AbdullahJalloul/Thermostat_V1/Kicad/Image/Thermostat_V1 top.png

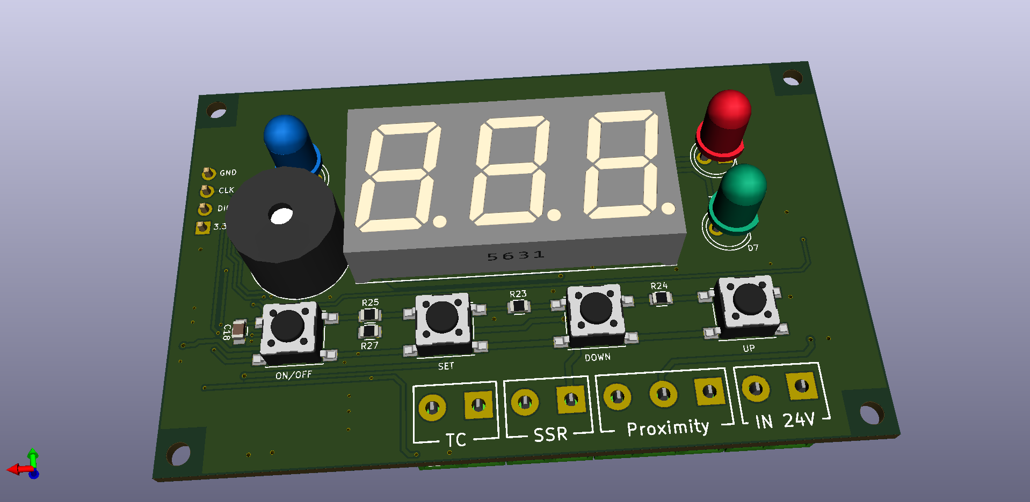
Kicad/Image/Thermostat_V1 top.png
