AbdullahJalloul/Thermostat_V1/Kicad/Image/Thermostat_V1 bot.png

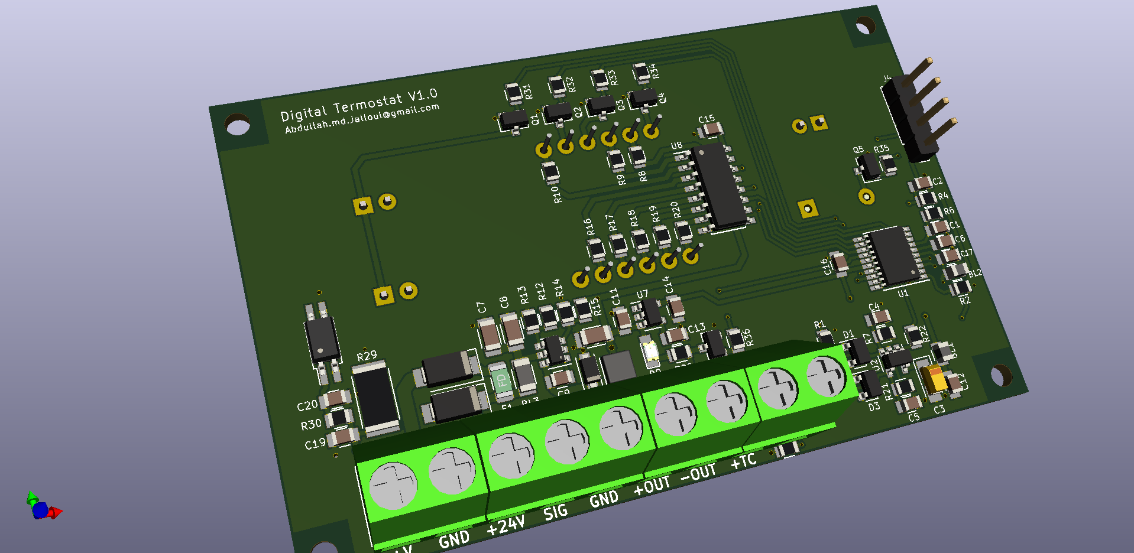
Kicad/Image/Thermostat_V1 bot.png
