AbdullahJalloul/Thermostat_V1/Kicad/Thermostat_V1.sch

## KiCad design Kicad/Thermostat_V1.sch (2019-05-15)

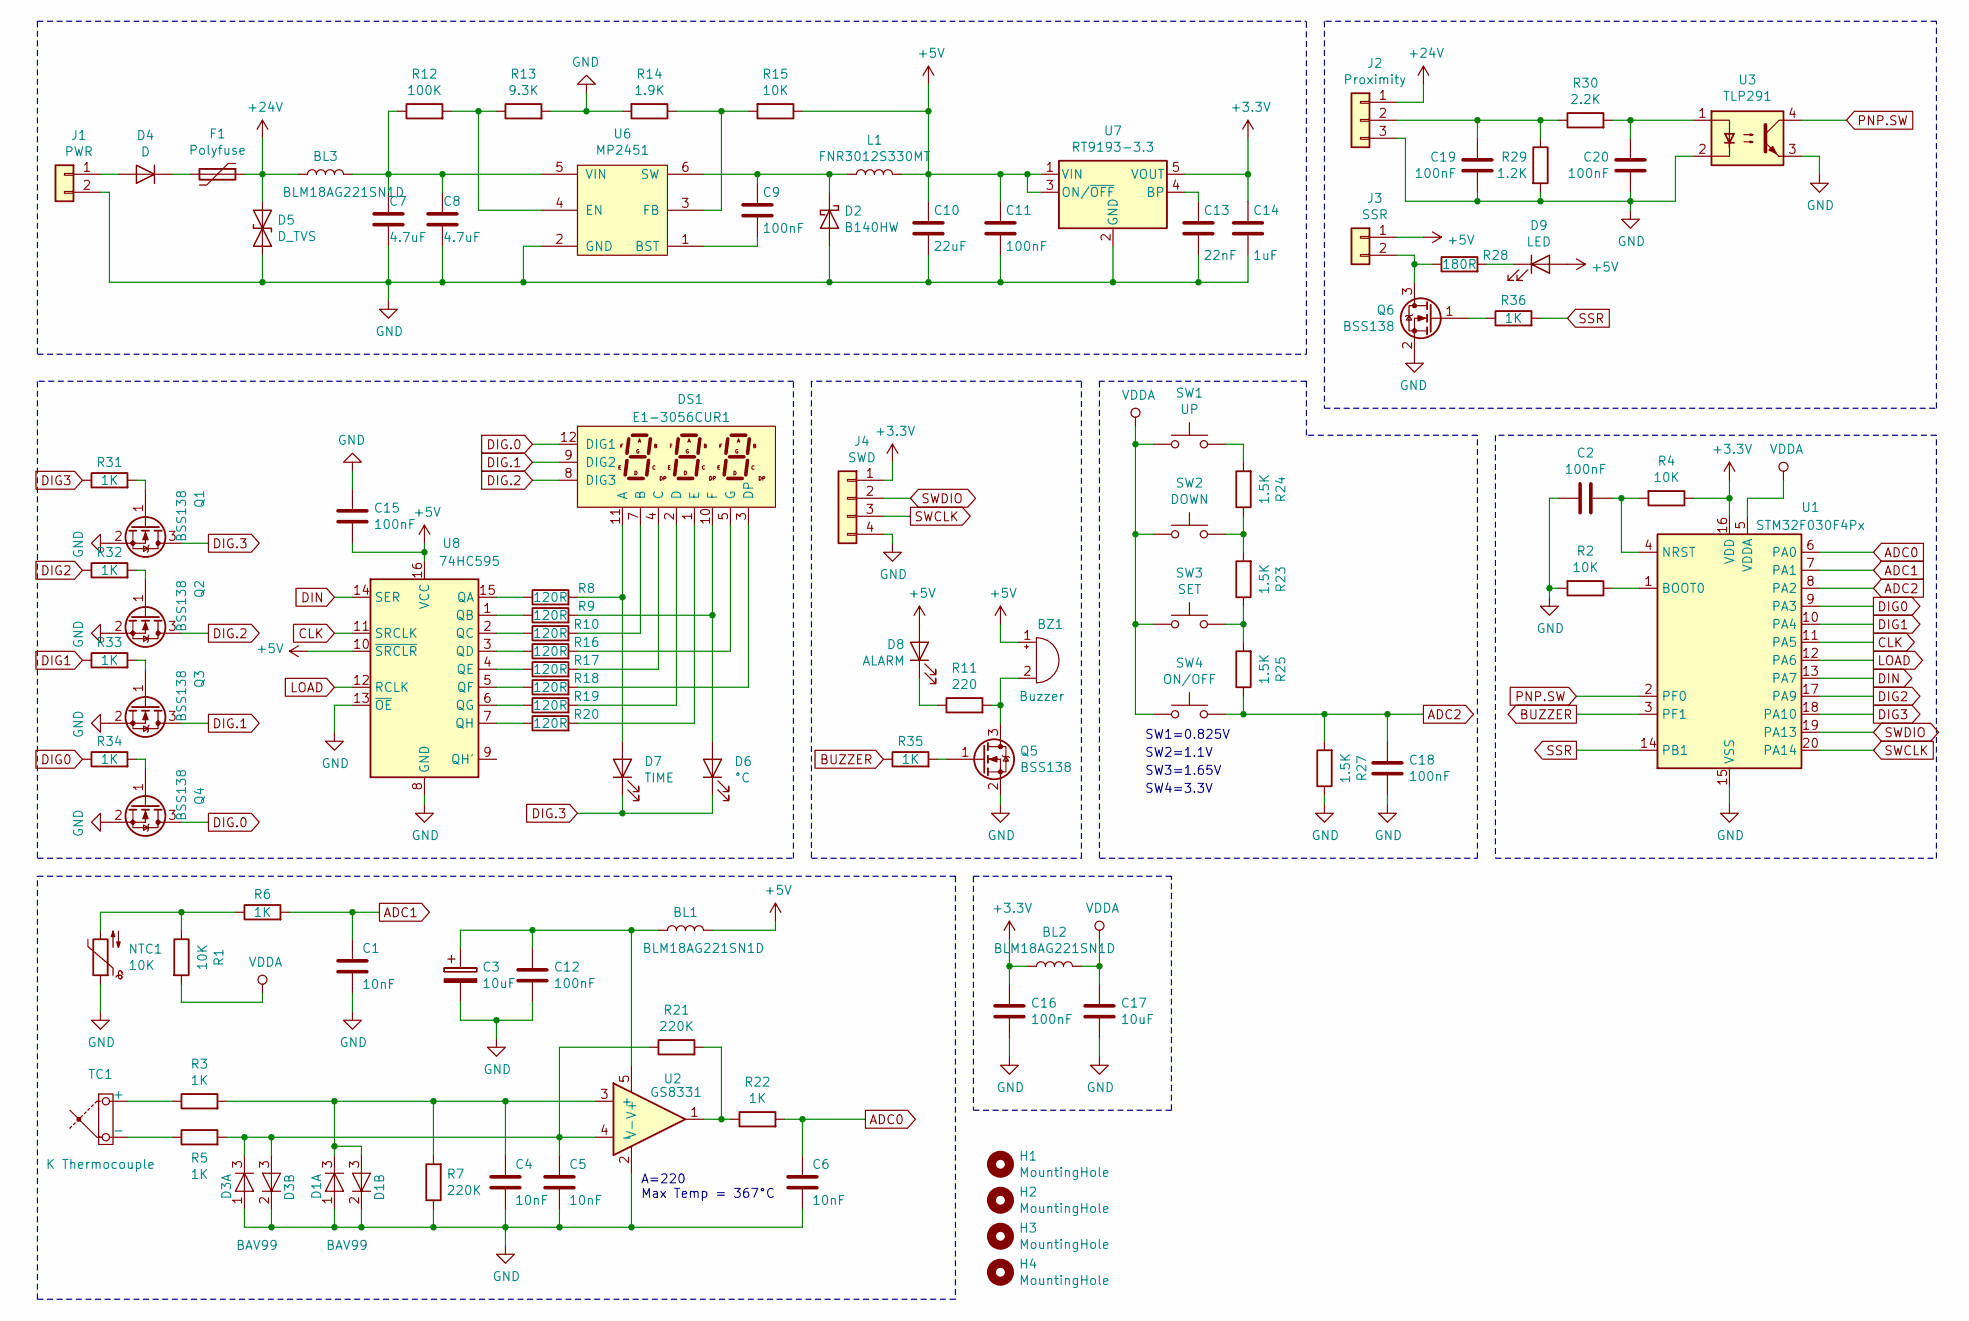
[picture p3: schematic Thermostat_V1.sch]

Parts:
BL1, BL2: BLM18AG221SN1D; L_0805
BL3: BLM18AG221SN1D; L_1206
BZ1: Buzzer; Buzzer_12x9.5RM7.6
C1, C4, C5, C6: 10nF; C_0805
C2, C9, C11, C12, C15, C16, C18, C19, C20: 100nF; C_0805
C3: 10uF; CP_Tantalum_Case-A_EIA-3216-18_Reflow
C7, C8: 4.7uF; C_1206
C10: 22uF; C_1206
C13: 22nF; C_0805
C14: 1uF; C_0805
C17: 10uF; C_0805
D1, D3: BAV99; SOT-23
D2: B140HW; D_SOD-123F
D4: D; D_SMA
D5: D_TVS; D_SMA
D6: °C; LED_D5.0mm
D7: TIME; LED_D5.0mm
D8: ALARM; LED_D5.0mm
D9: LED; LED_0805
DS1: E1-3056CUR1; E1-3056-CUR-1-CT
F1: Polyfuse; Fuse_1206_3216Metric
H1, H2, H3, H4: MountingHole; MountingHole_2.5mm
J1: PWR; TerminalBlock_bornier-2_P5.08mm
J2: Proximity; TerminalBlock_bornier-3_P5.08mm
J3: SSR; TerminalBlock_bornier-2_P5.08mm
J4: SWD; Pin_Header_Straight_1x04_Pitch2.54mm
L1: FNR3012S330MT; L_Taiyo-Yuden_MD-3030
NTC1: 10K; R_0805
Q1, Q2, Q3, Q4, Q5, Q6: BSS138; SOT-23
R1, R2, R4, R15: 10K; R_0805
R3, R5, R6, R22, R31, R32, R33, R34, R35, R36: 1K; R_0805
R7, R21: 220K; R_0805
R8, R9, R10, R16, R17, R18, R19, R20: 120R; R_0805
R11: 220; R_0805
R12: 100K; R_0805
R13: 9.3K; R_0805
R14: 1.9K; R_0805
R23, R24, R25, R27: 1.5K; R_0805
R28: 180R; R_0805
R29: 1.2K; R_2512
R30: 2.2K; R_0805
SW1: UP; SW_SPST_PTS645
SW2: DOWN; SW_SPST_PTS645
SW3: SET; SW_SPST_PTS645
SW4: ON/OFF; SW_SPST_PTS645
TC1: K Thermocouple; TerminalBlock_bornier-2_P5.08mm
U1: STM32F030F4Px; TSSOP-20_4.4x6.5mm_Pitch0.65mm
U2: GS8331; SOT-23-5
U3: TLP291; SO-4_4.4x2.3mm_Pitch1.27mm
U6: MP2451; SOT-23-6
U7: RT9193-3.3; SOT-23-5
U8: 74HC595; SOIC-16_3.9x9.9mm_Pitch1.27mm

Connections:
+3.3V: BL2.1, C14.2, C16.2, J4.1, R4.1, U1.16 (VDD), U7.5 (VOUT)
+5V: BL1.2, BZ1.1 (-), C10.2, C11.2, C15.1, D8.2 (A), D9.2 (A), J3.1, L1.2, R15.1, U7.1 (VIN), U7.3 (ON/~OFF~), U8.10 (~SRCLR), U8.16 (VCC)
+24V: BL3.1, D5.1 (A1), F1.1, J2.1
ADC0: C6.2, R22.2, U1.6 (PA0)
ADC1: C1.2, R6.2, U1.7 (PA1)
ADC2: C18.2, R25.1, R27.2, SW4.2, U1.8 (PA2)
BUZZER: R35.1, U1.3 (PF1)
CLK: U1.11 (PA5), U8.11 (SRCLK)
DIG0: R34.1, U1.9 (PA3)
DIG1: R33.1, U1.10 (PA4)
DIG2: R32.1, U1.17 (PA9)
DIG3: R31.1, U1.18 (PA10)
DIG.0: DS1.12 (DIG1), Q4.3 (D)
DIG.1: DS1.9 (DIG2), Q3.3 (D)
DIG.2: DS1.8 (DIG3), Q2.3 (D)
DIG.3: D6.1 (K), D7.1 (K), Q1.3 (D)
DIN: U1.13 (PA7), U8.14 (SER)
GND: C1.1, C2.1, C3.2, C4.1, C5.1, C6.1, C7.1, C8.1, C10.1, C11.1, C12.1, C13.1, C14.1, C15.2, C16.1, C17.1, C18.1, C19.1, C20.1, D1.1 (A), D1.2 (K), D2.2 (A), D3.1 (A), D3.2 (K), D5.2 (A2), J1.2, J2.3, J4.4, NTC1.1, Q1.2 (S), Q2.2 (S), Q3.2 (S), Q4.2 (S), Q5.2 (S), Q6.2 (S), R2.2, R7.1, R13.2, R14.2, R27.1, R29.2, U1.15 (VSS), U2.2 (V-), U3.2, U3.3, U6.2 (GND), U7.2 (GND), U8.8 (GND), U8.13 (~OE)
LOAD: U1.12 (PA6), U8.12 (RCLK)
unnamed: BL1.1, C3.1, C12.2, U2.5 (V+)
unnamed: BL3.2, C7.2, C8.2, R12.1, U6.5 (VIN)
unnamed: BZ1.2 (+), Q5.3 (D), R11.2
unnamed: C2.2, R4.2, U1.4 (NRST)
unnamed: C4.2, D1.3 (K), R3.2, R7.2, U2.3 (+)
unnamed: C5.2, D3.3 (K), R5.2, R21.1, U2.4 (-)
unnamed: C9.1, U6.1 (BST)
unnamed: C9.2, D2.1 (K), L1.1, U6.6 (SW)
unnamed: C13.2, U7.4 (BP)
unnamed: C19.2, J2.2, R29.1, R30.1
unnamed: C20.2, R30.2, U3.1
unnamed: D4.1 (K), F1.2
unnamed: D4.2 (A), J1.1
unnamed: D6.2 (A), DS1.10 (F), R9.2
unnamed: D7.2 (A), DS1.11 (A), R8.2
unnamed: D8.1 (K), R11.1
unnamed: D9.1 (K), R28.2
unnamed: DS1.1 (E), R20.2
unnamed: DS1.2 (D), R19.2
unnamed: DS1.3 (DP), R18.2
unnamed: DS1.4 (C), R17.2
unnamed: DS1.5 (G), R16.2
unnamed: DS1.7 (B), R10.2
unnamed: J3.2, Q6.3 (D), R28.1
unnamed: NTC1.2, R1.1, R6.1
unnamed: Q1.1 (G), R31.2
unnamed: Q2.1 (G), R32.2
unnamed: Q3.1 (G), R33.2
unnamed: Q4.1 (G), R34.2
unnamed: Q5.1 (G), R35.2
unnamed: Q6.1 (G), R36.1
unnamed: R2.1, U1.1 (BOOT0)
unnamed: R3.1, TC1.1 (+)
unnamed: R5.1, TC1.2 (-)
unnamed: R8.1, U8.15 (QA)
unnamed: R9.1, U8.1 (QB)
unnamed: R10.1, U8.2 (QC)
unnamed: R12.2, R13.1, U6.4 (EN)
unnamed: R14.1, R15.2, U6.3 (FB)
unnamed: R16.1, U8.3 (QD)
unnamed: R17.1, U8.4 (QE)
unnamed: R18.1, U8.5 (QF)
unnamed: R19.1, U8.6 (QG)
unnamed: R20.1, U8.7 (QH)
unnamed: R21.2, R22.1, U2.1
unnamed: R23.1, R25.2, SW3.2
unnamed: R23.2, R24.1, SW2.2
unnamed: R24.2, SW1.2
PNP.SW: U1.2 (PF0), U3.4
SSR: R36.2, U1.14 (PB1)
SWCLK: J4.3, U1.20 (PA14)
SWDIO: J4.2, U1.19 (PA13)
VDDA: BL2.2, C17.2, R1.2, SW1.1, SW2.1, SW3.1, SW4.1, U1.5 (VDDA)

Notes on the sheet:
SW1=0.825V
SW2=1.1V
SW3=1.65V
SW4=3.3V
A=220 Max Temp = 367°C
