AbdullahJalloul/Thermostat_V1/firmware/Core/Src/main.c

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

/* Includes ------------------------------------------------------------------*/
#include "main.h"

/* USER CODE BEGIN Includes */
#include "Eeprom.h"
#include "Config.h"
#include "Menu.h"
#include "Buzzer.h"
#include "AnalogButtons.h"
#include "ThermocoupleSensor.h"
/* USER CODE END Includes */

/* USER CODE BEGIN PTD */
uint8_t  ADC1_Successful;
uint16_t ADC1_DMA_Buffer[3];
uint32_t ADC1_Sampels[3], ADC1_Result[3];
uint32_t PreviousTime;
/* USER CODE END PTD */

/* USER CODE BEGIN PD */
extern uint8_t OneSecond;
/* USER CODE END PD */

ADC_HandleTypeDef hadc;
DMA_HandleTypeDef hdma_adc;

SPI_HandleTypeDef hspi1;

TIM_HandleTypeDef htim3;
TIM_HandleTypeDef htim14;

void SystemClock_Config(void);
static void MX_GPIO_Init(void);
static void MX_DMA_Init(void);
static void MX_SPI1_Init(void);
static void MX_ADC_Init(void);
static void MX_TIM3_Init(void);
static void MX_TIM14_Init(void);
/**
  * @brief  The application entry point.
  * @retval int
  */
int main(void)
{
  /* MCU Configuration--------------------------------------------------------*/

  /* Reset of all peripherals, Initializes the Flash interface and the Systick. */
  HAL_Init();

  /* Configure the system clock */
  SystemClock_Config();

  /* Initialize all configured peripherals */
  MX_GPIO_Init();
  MX_DMA_Init();
  MX_SPI1_Init();
  MX_ADC_Init();
  MX_TIM3_Init();
  MX_TIM14_Init();
  /* USER CODE BEGIN 2 */
  HAL_ADC_Start_DMA(&hadc, (uint32_t *)ADC1_DMA_Buffer, 3);
  HAL_ADC_Start(&hadc);
  HAL_TIM_Base_Start_IT(&htim3);
  HAL_TIM_PWM_Start(&htim14, TIM_CHANNEL_1);
  EEPROM_Read();
  HeaterTurnOff();
  /* USER CODE END 2 */

  /* Infinite loop */
  /* USER CODE BEGIN WHILE */
  while (1)
  {
    uint32_t CurrentTime = HAL_GetTick();

    if (ADC1_Successful) {
      ADC1_Successful = 0;
      AnalogButtonUpdate();
      MeasureThermocoupleOutput();
    }

    if (CurrentTime >= PreviousTime) {
      PreviousTime  = CurrentTime + 500;
      OneSecond ^= 1;
      HeaterUpdate();
      DisplayUpdate();
    }

    HeaterSwitch();
    BuzzerUpdate();
    /* USER CODE END WHILE */

    /* USER CODE BEGIN 3 */
  }
  /* USER CODE END 3 */
}

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
/* USER CODE BEGIN 4 */
void HAL_ADC_ConvCpltCallback(ADC_HandleTypeDef* hadc) {
  static uint8_t ADC1Sampales = 0;
  ADC1_Sampels[ADC1_Channel_1] += ADC1_DMA_Buffer[ADC1_Channel_1];
  ADC1_Sampels[ADC1_Channel_2] += ADC1_DMA_Buffer[ADC1_Channel_2];
  ADC1_Sampels[ADC1_Channel_3] += ADC1_DMA_Buffer[ADC1_Channel_3];

  if (++ADC1Sampales >= ADCn_MAX_SAMPLES) {
    ADC1Sampales = 0;
    ADC1_Result[ADC1_Channel_1] = ADC1_Sampels[ADC1_Channel_1];
    ADC1_Result[ADC1_Channel_2] = ADC1_Sampels[ADC1_Channel_2];
    ADC1_Result[ADC1_Channel_3] = ADC1_Sampels[ADC1_Channel_3];
    ADC1_Sampels[ADC1_Channel_1] = 0;
    ADC1_Sampels[ADC1_Channel_2] = 0;
    ADC1_Sampels[ADC1_Channel_3] = 0;
    ADC1_Successful = 1;
  }
  hadc->Instance->CR |= ADC_CR_ADSTART;
}


/* USER CODE END 4 */
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
