AbdullahJalloul/Thermostat_V1/(notices)

Notices in the files:
firmware/Core/Src/main.c:
COPYRIGHT(c) 2019 STMicroelectronics
(C) COPYRIGHT STMicroelectronics *****END OF FILE
